MinhTu695/Smart-RFID-Attendance-System/HW/Schematic+PCB.pdf

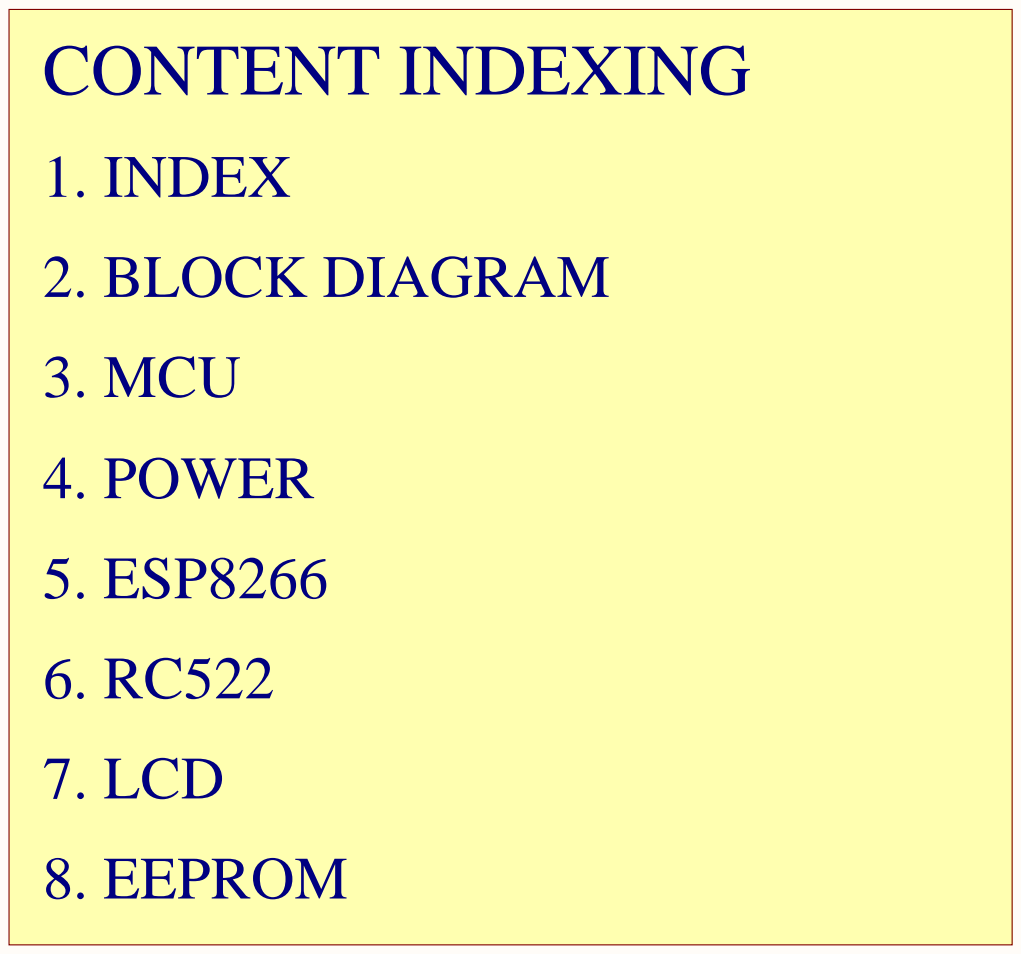
[picture p9: page 1]

SMART RFID ATTENDANCE SYSTEM

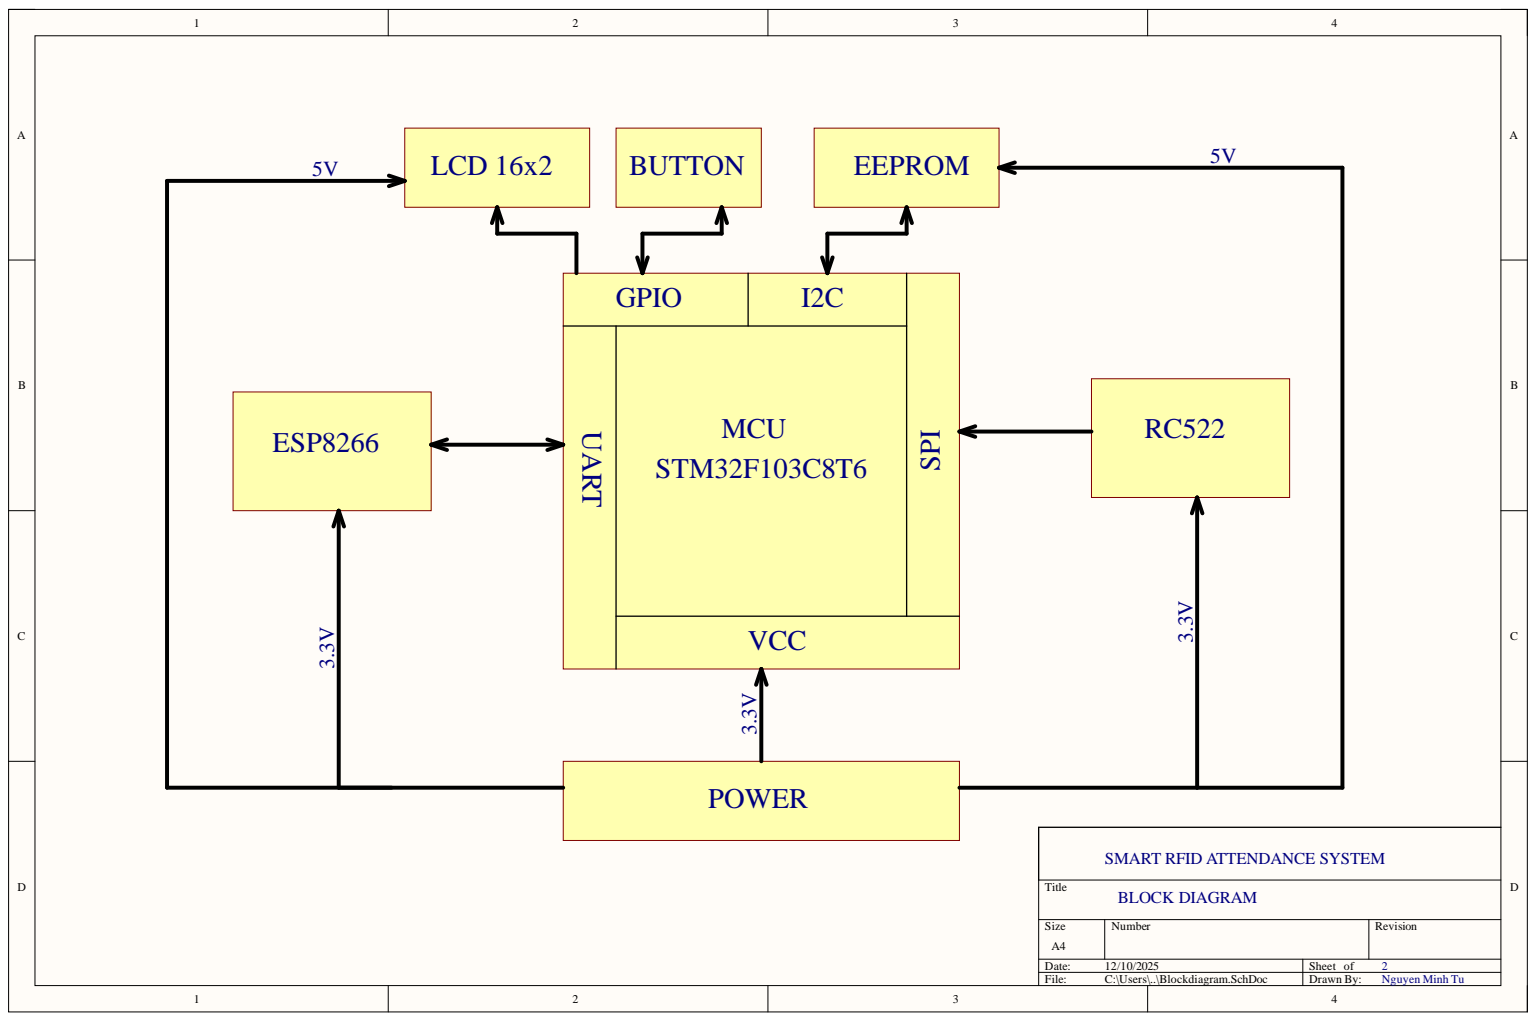
[picture p10: page 2]

GPIO | I2C

MCU STM32F103C8T6

SMART RFID ATTENDANCE SYSTEM

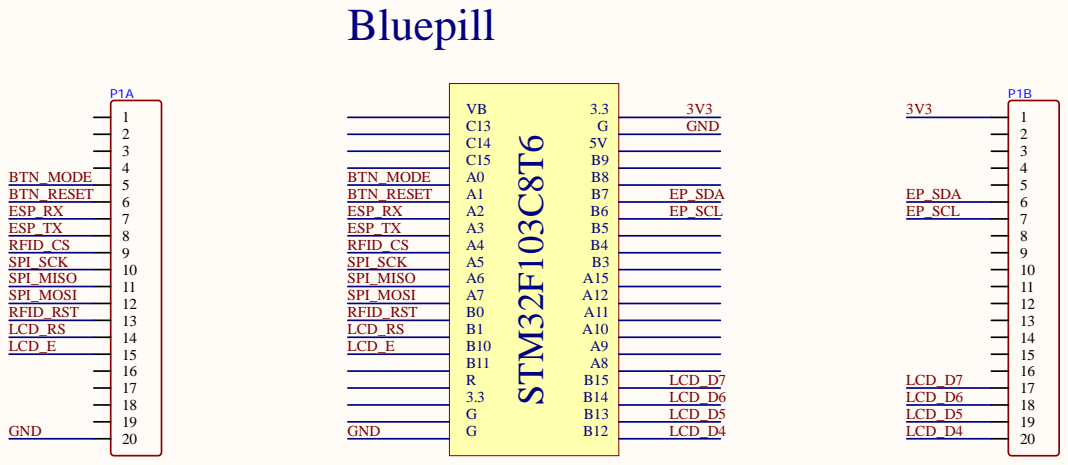
[picture p11: page 3]

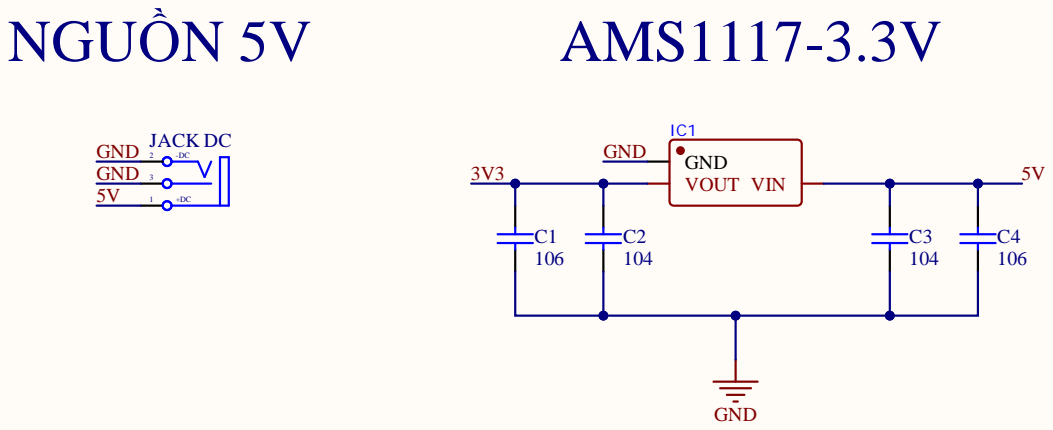
[picture p12: page 4]

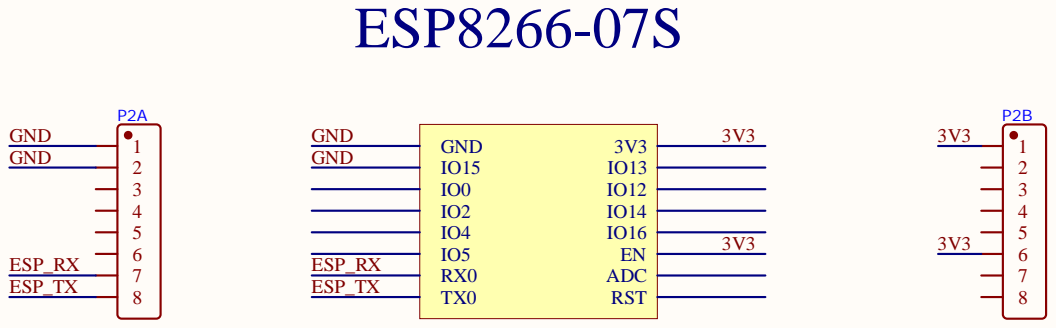
[picture p13: page 5]

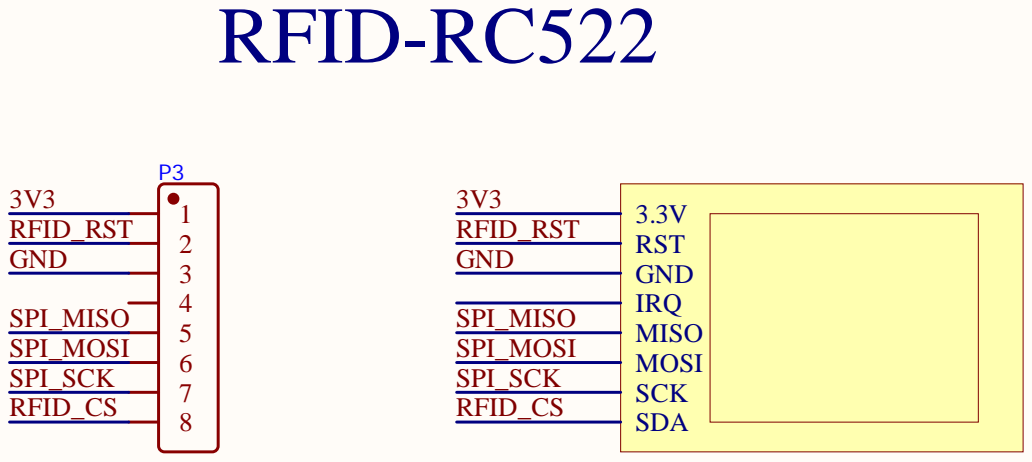
[picture p14: page 6]

SMART RFID ATTENDANCE SYSTEM

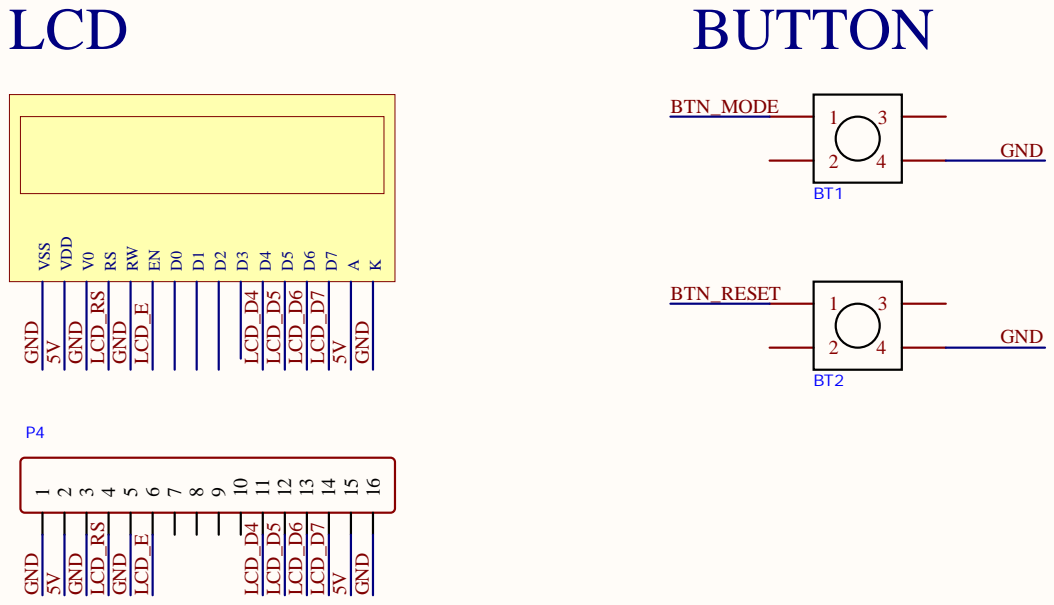
[picture p15: page 7]

SMART RFID ATTENDANCE SYSTEM

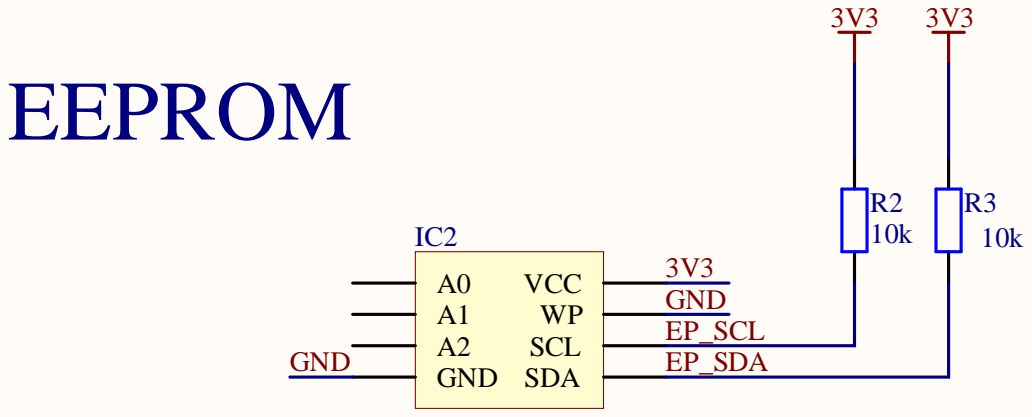
[picture p16: page 8]

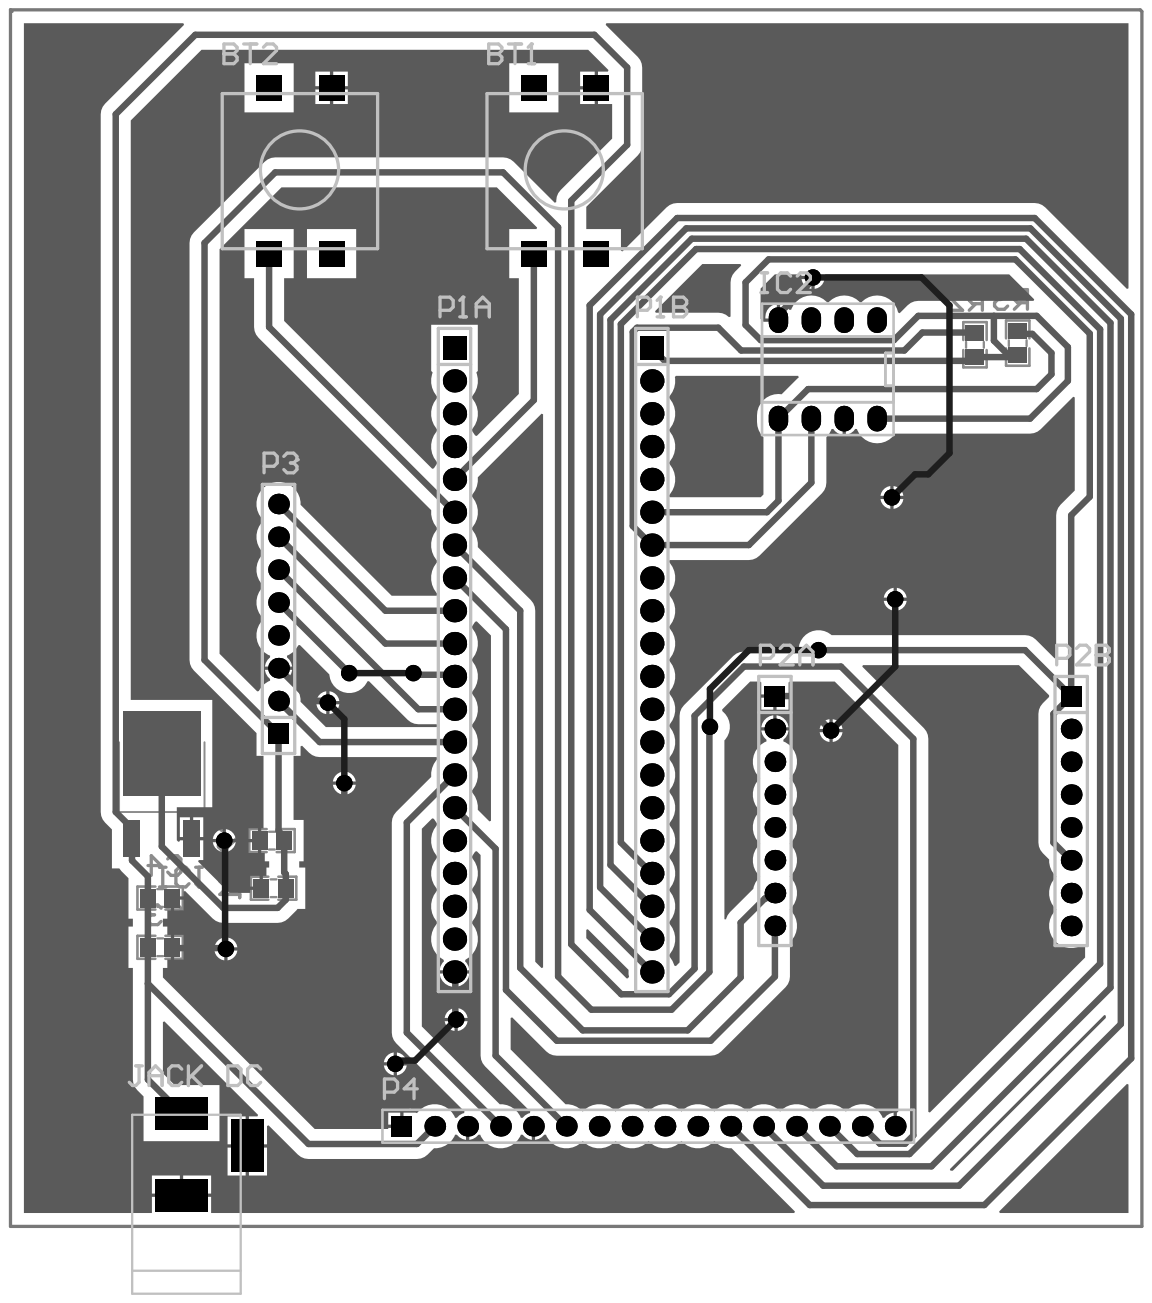
[picture p17: page 9]
