MinhTu695/Smart-RFID-Attendance-System/FW/BluePill_Attendance/Core/Inc/main.h

#define LED_BUILTIN_Pin GPIO_PIN_13
#define LED_BUILTIN_GPIO_Port GPIOC
#define BTN_MODE_Pin GPIO_PIN_0
#define BTN_MODE_GPIO_Port GPIOA
#define BTN_SEND_Pin GPIO_PIN_1
#define BTN_SEND_GPIO_Port GPIOA
#define RFID_CS_Pin GPIO_PIN_4
#define RFID_CS_GPIO_Port GPIOA
#define RFID_RST_Pin GPIO_PIN_0
#define RFID_RST_GPIO_Port GPIOB
#define LCD_RS_Pin GPIO_PIN_1
#define LCD_RS_GPIO_Port GPIOB
#define LCD_EN_Pin GPIO_PIN_10
#define LCD_EN_GPIO_Port GPIOB
#define LCD_D4_Pin GPIO_PIN_12
#define LCD_D4_GPIO_Port GPIOB
#define LCD_D5_Pin GPIO_PIN_13
#define LCD_D5_GPIO_Port GPIOB
#define LCD_D6_Pin GPIO_PIN_14
#define LCD_D6_GPIO_Port GPIOB
#define LCD_D7_Pin GPIO_PIN_15
#define LCD_D7_GPIO_Port GPIOB
