MinhTu695/Smart-RFID-Attendance-System/FW/BluePill_Attendance/App/app_main.h

#ifndef APP_MAIN_H_
#define APP_MAIN_H_

#include "main.h" // Kế thừa toàn bộ thư viện hệ thống

// Hàm khởi tạo (Chạy 1 lần)
void App_Init(void);

// Hàm vòng lặp (Chạy mãi mãi - giống while(1))
void App_Loop(void);

#endif /* APP_MAIN_H_ */
